weif3383-cloud/sweeping-robot/代辦.md

# 代辦

## 🔜 下一步：MPU6050 上車測試（robot_wifi）
- [x] MPU6050 平貼在下層、靠近兩輪中間、晶片朝上、貼牢（SDA 21、SCL 22、3.3V、GND）
- [x] 在 `robot_wifi/` 把 `secrets_example.h` 複製成 `secrets.h`，填家裡 WiFi（2.4 GHz）
- [x] 燒錄 `robot_wifi.ino`，開機時車子靜止 1 秒（量零點）
- [x] 電腦開 http://robot.local（或網頁上的 IP），確認網頁正常
- [x] 用手順時針轉車子，陀螺儀方向要變大（變小就按「反轉方向」）
- [x] 跑一次原地轉 90°，看回報「陀螺儀 vs 編碼器推算」差多少
- [x] 跟 Claude 說，讓 Claude 讀 http://robot.local/data 分析數據

## 之後：陀螺儀控制
- [x] 階段 ③：原地轉彎改用陀螺儀角度停 — 實測 90° 準到 ±0.5°
- [x] 階段 ③-2：提前量跟著轉速 — 實測 45°/90°/180° 都在 ±1°
- [x] 階段 ④：直走鎖定方向 — 實測偏差從 −7° 降到 ±0.9°
- [x] 陀螺儀比例校正：轉 360° 陀螺儀說 359°、目視也差約 1° → 比例正確
- [x] 燒錄 v4、自動學直走微調（鎖方向開時偏 ±1.2° 內）
- [x] 燒錄 v5（左右輪大小比例）→ 鎖方向關掉時偏差從 −4°～+5° 降到大多 ±1° 內
- [ ] 無線燒錄：Windows WiFi 設成私人網路、防火牆允許 espota / Arduino IDE
- [x] 測試偏移是車子還是地板 → 主要是車子（一直往車子左邊偏），地板讓偏差忽大忽小
- [x] 輪距校正：陀螺儀實測 6 次轉彎 → 199 mm
- [x] 輪徑校正：30 cm 尺量 3 趟 → 66.9 mm（距離誤差從約 3% 降到 0）
- [x] 燒錄 v6（照地圖修正路線）→ 正方形測試回到起點只差 1.2 cm
- [ ] 查為什麼 Claude 連不上機器人網頁（看序列埠的 IP / WiFi 訊息）

## 紅外線感測器 ×2（已決定：第一層側面，貼牆碰觸偵測；沒有防跌落）
- [x] 模組是 4 腳（VCC / GND / A0 / D0），只接 D0，A0 不接
- [x] 腳位寫進 `docs/PINOUT_v2.md` 第 6.5 節：左 D0 → GPIO 16、右 D0 → GPIO 17，VCC 接 3.3V
- [ ] 接線並燒錄 `迭代四_感測器/ir_test/ir_test.ino`，確認靠近 / 遠離的讀值與極性（先接一顆也可以）
- [ ] 調模組上的電位器，確認貼牆多近會偵測到
- [ ] 注意：沒有防跌落 → 測試只能在平地、遠離桌邊和樓梯
- [ ] （之後可選）前保險桿微動開關 GPIO 18 / 19（已預留）

## 掃地演算法（規劃見 `docs/演算法規劃.md`）
- [x] `迭代五_演算法/sweep_sim.html` 網頁模擬器（階段 1：空場地）— 2×2 m 模擬覆蓋率平均 93%、最差 90.7%
- [ ] 使用者試玩模擬器，確認流程是不是他要的
- [ ] 紅外線、超音波實測（ir_test），確認實際偵測距離，回頭調模擬器參數
- [x] robot_wifi v7：`O` 設定座標、/status 回報超音波與紅外線、`P x,y,1` 超音波 8 cm 停、超音波 5 次平均、CORS（模擬測試：設 8 cm 停在 7.2～7.7 cm）
- [ ] 燒錄 v7（先關 Arduino IDE 再讓 Claude 寫入），網頁「感測器」卡片確認超音波距離和紅外線 ●○ 正確
- [ ] 模擬器加「連接實車」：把 cleanRoom 的 bot 介面接到 /cmd、/status（座標系換算：韌體 y 朝前、順時針為正）
- [ ] 實車階段 1：網頁規劃 → 控制實車；驗收：覆蓋率 > 90%、終點離模擬值 5 cm 內
- [ ] 階段 2：加障礙物（超音波偵測、牆驗證、繞過 / 補掃），保留手動輸入場地大小

## 硬體
- [ ] 上層底盤列印與組裝
- [ ] 選吸塵風扇、側刷、濾網；設計集塵盒、吸塵嘴、風扇座、上蓋
- [ ] HC-SR04（分壓）、N20 側刷 + MOSFET + 1N5819、電源（BMS / Type-C 充電 / MP1584 5.0 V）上車測試

## 完成
- [x] 第一版小車、遙控
- [x] v2 下層底盤列印與組裝
- [x] 編碼器讀取、走指定圈數、提前量自動學習、左右同步、柔和停車、20/40 格
- [x] 無線網頁控制、路徑地圖（encoder_wifi）
- [x] GitHub 同步（weif3383-cloud/sweeping-robot）
