weif3383-cloud/sweeping-robot/迭代三_陀螺儀/說明.md

# 迭代三：陀螺儀（目前最新）

加入 MPU6050 陀螺儀，車頭方向不再只靠編碼器推算。

| 順序 | 程式 | 做什麼 |
|---|---|---|
| 1 | `robot_wifi/` | **目前主程式**：encoder_wifi ＋ 陀螺儀（自動零點、正負號自動判斷、地圖方向）＋ 家裡 WiFi ＋ `/data` 數據 |

家裡 WiFi：把 `robot_wifi/secrets_example.h` 複製成 `secrets.h` 填入（不會上傳 GitHub）。

## v7（2026-11-15）：給掃地演算法用
- 超音波 HC-SR04（Trig 4、Echo 經分壓 → 39）：每 60 ms 量一次，網頁「感測器」卡片顯示
- 紅外線 ×2（D0 → 16 / 17）：網頁顯示 ●（偵測到）○（沒有）；如果剛好相反，打 `I0`
- 新指令：
  - `P60,0,1`：走到 (60, 0)，途中前方超音波 ≤ 8 cm 就停（`V8` 改距離）
  - `O30,12,90`：直接設定目前座標與方向（空著的欄位不改，例如 `O,,90`）
  - `U`：印出超音波與紅外線讀值
- `/status` 多了 `son`（超音波平均 cm，-1 = 量不到）、`sn1`、`irl`、`irr`、`blk`（上一個 P 被擋住）
- 電腦上直接開的網頁（例如 `迭代五_演算法/sweep_sim.html`）也可以呼叫 `/cmd`、`/status`（加了 CORS）
- 超音波沒接的話讀值會亂跳或量不到，其他功能不受影響
