weif3383-cloud/sweeping-robot/迭代五_演算法/說明.md

# 迭代五：掃地演算法

| 檔案 | 用途 | 狀態 |
|---|---|---|
| `sweep_sim.html` | 網頁模擬器（階段 1：空場地）。用瀏覽器直接開，不用安裝 | 2026-11-15 完成，模擬驗證過 |

規劃的決定與限制見 `docs/演算法規劃.md`。

## 怎麼用
1. 在檔案上按兩下，用瀏覽器（Chrome / Edge）開啟 `sweep_sim.html`。
2. 按「開始清掃」。左邊是真實情況（白色＝真的掃過），右邊是機器人自己以為的地圖。
3. 可以改：場地寬 / 長（80～300 cm）、亂數（換一個數字＝換一個起點和一組誤差）、誤差大小、模擬速度。
4. 「碰牆校正座標」「沿牆繞一圈」可以關掉，比較有沒有差。

## 演算法流程（`cleanRoom`）
1. **找角落**：往前走到牆（超音波 8 cm 停），左轉走到第二面牆。角落＝原點，順便量對面兩面牆的位置。
2. **弓字形**：行距 20 cm，每行走到前面的牆為止。每行走完用超音波修正 x、y，並從「這一行左右偏了多少」反推車頭歪幾度一起修正。
3. **沿牆繞一圈**：車身離牆 2 cm，牆在右手邊。每 40 cm 看一次右邊紅外線修正離牆距離（亮＝太近或剛好，沒亮＝太遠）。
4. **走回起點**。

## 模擬結果（2×2 m，各 12 組亂數）
| 誤差 | 校正 | 覆蓋率 平均 / 最差 | 最後定位誤差 平均 | 撞牆 平均 |
|---|---|---|---|---|
| 1× | 開 | 93.0% / 90.7% | 2.6 cm | 1.4 次 |
| 1× | 關 | 91.0% / 84.6% | 3.3 cm | 3.5 次 |
| 2× | 開 | 92.1% / 87.6% | 4.7 cm | 3.8 次 |
| 2× | 關 | 88.5% / 77.4% | 6.4 cm | 4.3 次 |

- 「撞牆」是貼牆走（離牆 2 cm）時車身碰到牆，不是高速撞上去。
- 「誤差 1×」是猜的：里程計距離 ±1%、陀螺儀漂移 ±0.01 °/s、起點車頭歪 ±1.5°、超音波 ±0.3 cm 起跳。實車的誤差要上車後才知道。

## 已知限制
- 只適用**長方形、沒有障礙物**的場地（障礙物是階段 2）。
- 起點要**大致正對一面牆**（歪超過約 25° 超音波量不到）。
- 場地邊長超過約 3 m，超音波量不到對面的牆。
- 圓形車身掃不到四個角落，牆邊約 3 cm 也掃不到，所以覆蓋率上限大約 95%。

## 程式結構
- 第一部分「規劃程式」只透過 `bot` 介面（`setPose` / `turnTo` / `goTo` / `sense`）控制機器人，模擬器和實車共用。
- 上實車前，`robot_wifi` 要新增：
  - 設定座標的指令（對應 `setPose`）
  - `/status` 回報超音波距離和左右紅外線
  - `P x,y` 加「超音波 ≤ 8 cm 就停」的選項，並回報是不是被擋住
  - 超音波連量 5 次取平均
