weif3383-cloud/sweeping-robot/迭代一_小車馬達/說明.md

# 迭代一：小車馬達

第一版小車，讓馬達動起來。

| 順序 | 程式 | 做什麼 |
|---|---|---|
| 1 | `car_test/` | 序列埠打指令測馬達（w/s/a/d、單輪、PWM 調整） |
| 2 | `car_test02/` | car_test 的修改版 |

（手機遙控 `remote_car` 放在桌面另一個資料夾）
