weif3383-cloud/sweeping-robot/迭代二_編碼器/說明.md

# 迭代二：編碼器

加入 HC-020K 編碼器，知道輪子轉了幾格，再做成無線控制。

| 順序 | 程式 | 做什麼 |
|---|---|---|
| 1 | `encoder_test/` | 編碼器測試：計時器抗抖動、馬達一起測 |
| 2 | `encoder_read/` | 編碼器讀取 → 走指定圈數 → 提前煞車、自動學習（序列埠版） |
| 3 | `encoder_wifi/` | 無線網頁版：左右同步、柔和停車、20/40 格、路徑地圖（沒有 MPU 的穩定版） |
