weif3383-cloud/sweeping-robot/迭代四_感測器/說明.md

# 迭代四：感測器（紅外線、超音波、保險桿）

| 程式 | 用途 | 狀態 |
|---|---|---|
| `ir_test/ir_test.ino` | 紅外線 ×2 讀值測試（GPIO 16 / 17） | 2026-11-15 寫好，等使用者接線測試 |

- 腳位見 `docs/PINOUT_v2.md` 第 6.5 節。
- ■ 表示 OUT = 0（多數模組代表偵測到東西），□ 表示 OUT = 1。
