weif3383-cloud/sweeping-robot/cad/prev_lower_iso.png

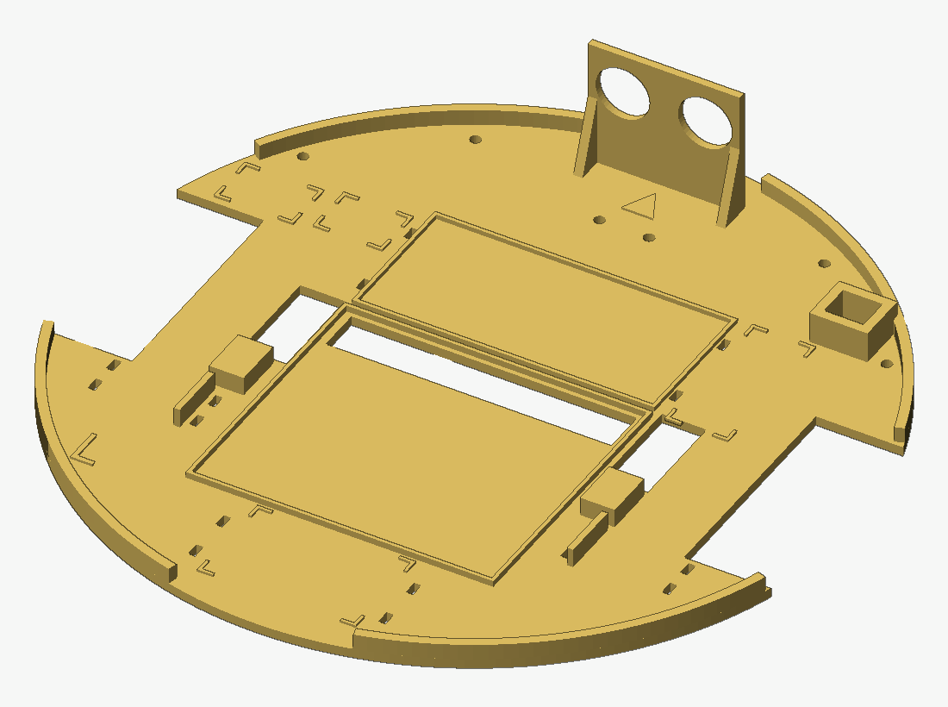
cad/prev_lower_iso.png
