weif3383-cloud/sweeping-robot/cad/prev_upper_iso.png

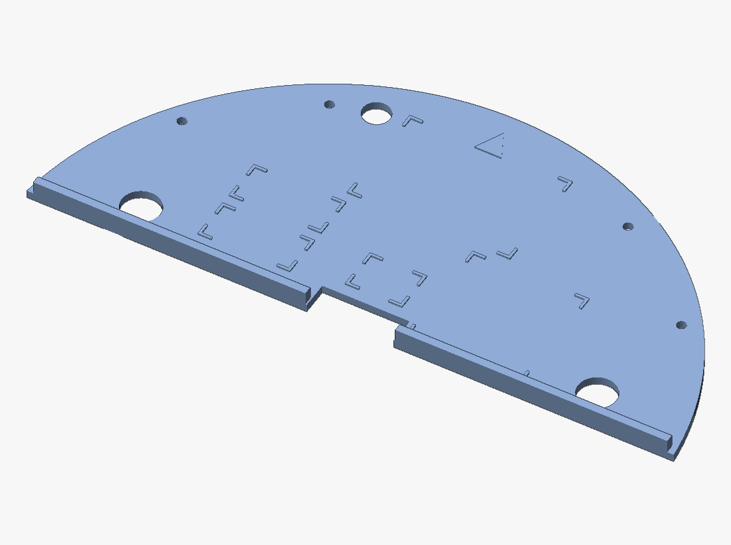
cad/prev_upper_iso.png
