weif3383-cloud/sweeping-robot/layout_v2_draft.png

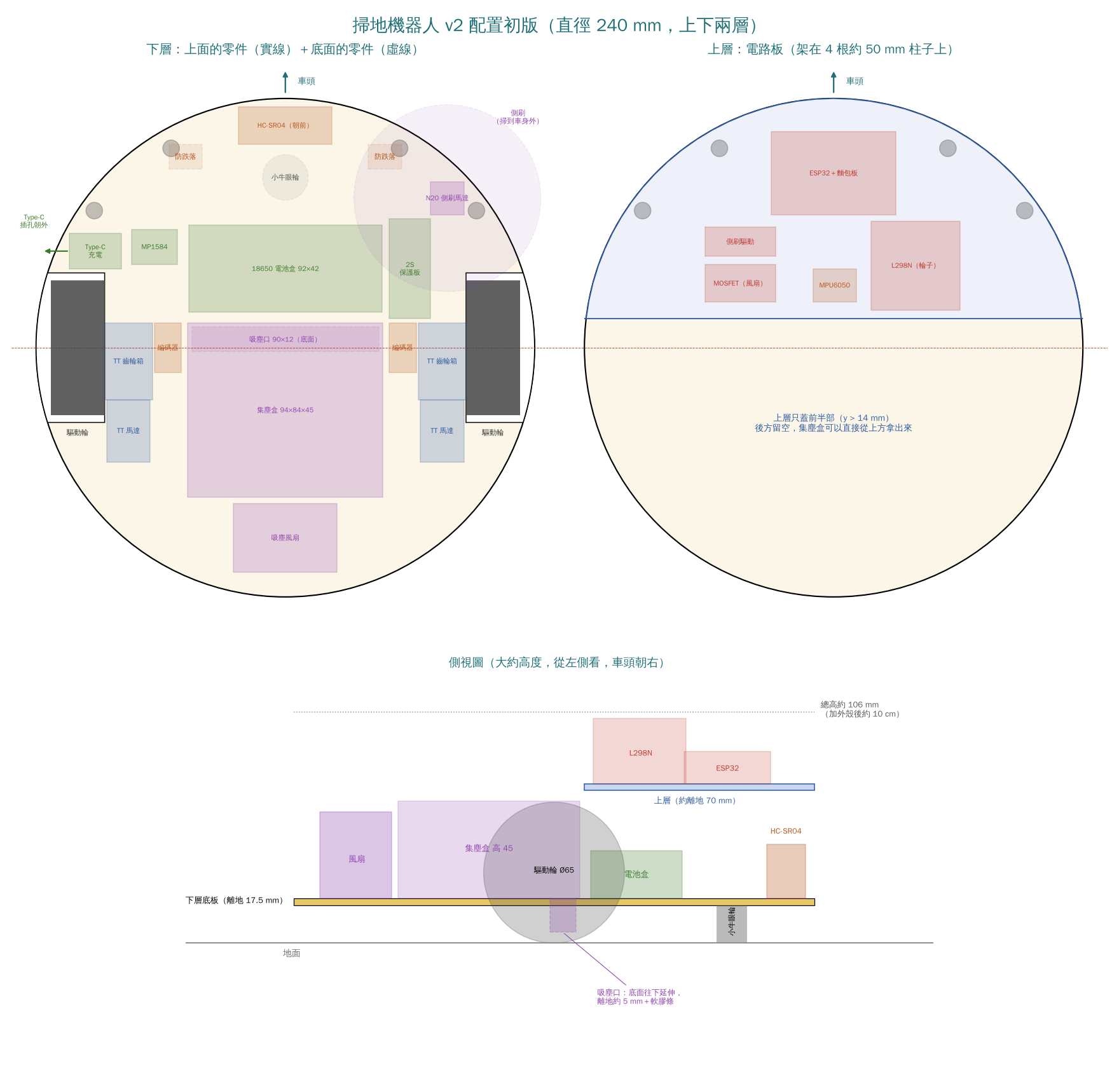
layout_v2_draft.png
