weif3383-cloud/sweeping-robot/cad/robot_v2_lower_deck.stl

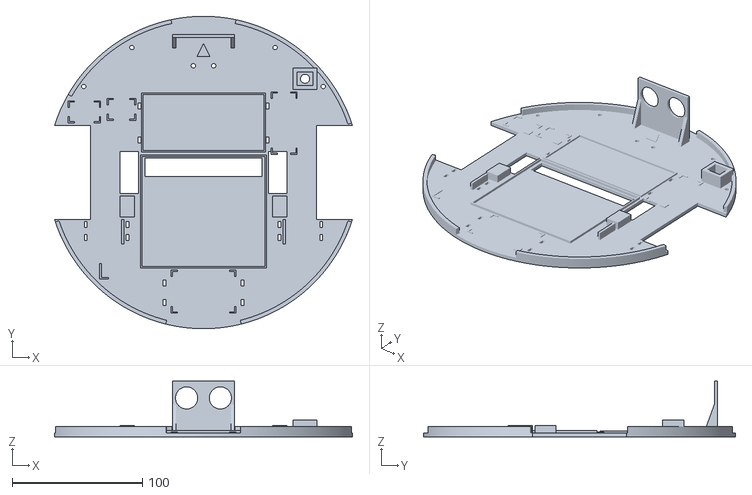
[picture p6: CAD file, 2026-11-07]
cad/robot_v2_lower_deck.stl
228.9 x 240.0 x 43.0
