weif3383-cloud/sweeping-robot/cad/robot_v2_upper_deck.stl

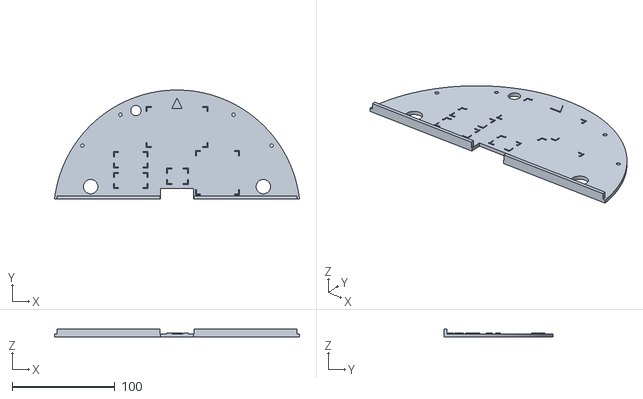
[picture p7: CAD file, 2026-11-07]
cad/robot_v2_upper_deck.stl
238.4 x 106.0 x 8.00
