weif3383-cloud/sweeping-robot/cad/assembly_lower_v2.png

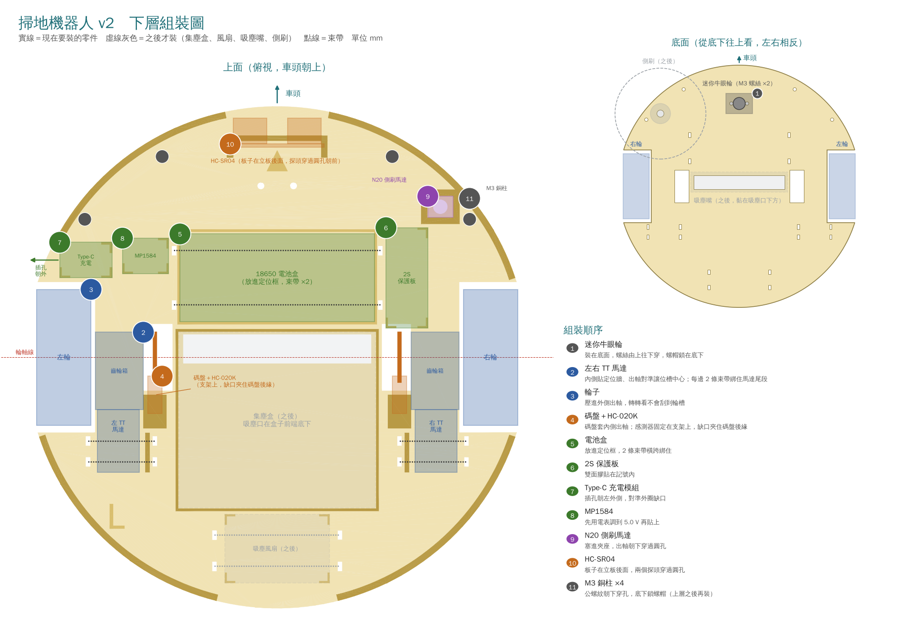
cad/assembly_lower_v2.png
