weif3383-cloud/sweeping-robot/TODO.md

# 待辦清單

## 🔜 下一步：MPU6050 上車測試（robot_wifi）
- [ ] MPU6050 平貼在下層、靠近兩輪中間、晶片朝上、貼牢（SDA 21、SCL 22、3.3V、GND）
- [ ] 在 `robot_wifi/` 把 `secrets_example.h` 複製成 `secrets.h`，填家裡 WiFi（2.4 GHz）
- [ ] 燒錄 `robot_wifi.ino`，開機時車子靜止 1 秒（量零點）
- [ ] 電腦開 http://robot.local（或網頁上的 IP），確認網頁正常
- [ ] 用手順時針轉車子，陀螺儀方向要變大（變小就按「反轉方向」）
- [ ] 跑一次原地轉 90°，看回報「陀螺儀 vs 編碼器推算」差多少
- [ ] 跟 Claude 說，讓 Claude 讀 http://robot.local/data 分析數據

## 之後：陀螺儀控制
- [ ] 階段 ③：原地轉彎改用陀螺儀角度停（快到時減速）
- [ ] 階段 ④：直走鎖定方向（陀螺儀 + 編碼器同步一起用）
- [ ] 陀螺儀比例校正（原地轉 5 圈，看實際轉幾圈）
- [ ] 正方形測試校正輪徑 `D` 與輪距 `W`

## 硬體
- [ ] 上層底盤列印與組裝
- [ ] 紅外線感測器 ×2 用途與安裝（討論中）
- [ ] 選吸塵風扇、側刷、濾網；設計集塵盒、吸塵嘴、風扇座、上蓋
- [ ] HC-SR04（分壓）、N20 側刷 + MOSFET + 1N5819、電源（BMS / Type-C 充電 / MP1584 5.0 V）上車測試

## 完成
- [x] 第一版小車、遙控
- [x] v2 下層底盤列印與組裝
- [x] 編碼器讀取、走指定圈數、提前量自動學習、左右同步、柔和停車、20/40 格
- [x] 無線網頁控制、路徑地圖（encoder_wifi）
- [x] GitHub 同步（weif3383-cloud/sweeping-robot）
