weif3383-cloud/sweeping-robot/(commit log)

2026-11-07 初始上傳：目前所有程式、設計檔與腳位表
    Claude-Session: https://claude.ai/code/session_016VkQpYHki4jqupFq9L7GeY
    [robot_v2_lower_deck.stl, robot_v2_upper_deck.stl]
2026-11-07 加入專案工作筆記 CLAUDE.md
    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
2026-11-07 新增 robot_wifi：MPU6050 陀螺儀、家裡 WiFi、/data 數據
    - 陀螺儀 Z 軸：開機量零點、停車時自動更新零點、正負號自動判斷
    - 地圖方向改用陀螺儀，網頁同時顯示編碼器推算方向比較
    - secrets.h 連家裡 WiFi（保留 RobotCar 熱點），robot.local
    - /data 提供參數、狀態、最近 30 趟紀錄
    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
2026-11-07 新增待辦清單 TODO.md
    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
2026-11-07 待辦清單改名為 代辦.md，加入紅外線感測器 TCRT5000 項目
    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
2026-11-07 程式依迭代分類：迭代一小車馬達、迭代二編碼器、迭代三陀螺儀
    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
2026-11-07 robot_wifi：轉彎改用陀螺儀決定停、輪距校正為 199 mm
    - 陀螺儀轉彎：最後 35° 減速，提前量左右各自學習並存在 Preferences
    - 正負號確認狀態、輪徑、輪距也存起來，重開機不用重來
    - 方向相反時立刻翻正負號，避免一直轉
    - 實測 6 次轉彎（陀螺儀 vs 編碼器）算出有效輪距 199 mm
    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
2026-11-07 robot_wifi v3：轉彎提前量跟著轉速、直走用陀螺儀鎖方向
    - 實測：固定提前度數讓 90° 準到 ±0.5°，但 45° 少轉、180° 多轉
    → 改學時間常數 K（提前度數 = K × 放開時轉速），左右各自學
    - 直走鎖方向：陀螺儀 PID + 編碼器同步只留 40% 比例項，兩輪平均走到才一起停
    - 新指令 J（鎖方向開關）、K（鎖方向參數），網頁加開關
    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
2026-11-07 robot_wifi：加入無線燒錄（OTA）
    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
2026-11-07 robot_wifi：寫入實車校準值（轉彎 K、直走鎖方向 PID），鎖方向參數也存起來
    實測（2026-11-07）：
    - 轉彎 26 次學出 K 右 0.094 / 左 0.079 秒，45°/90°/180° 誤差都在 ±1° 內
    - 直走 2 圈：鎖方向關 −4.7～−7.1°；KH14/KHI25/KHD0.7 → ±0.9° 內
    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
2026-11-07 robot_wifi v4：直走微調自動學習、直走一律平均走到一起停
    - 實測車子本身往左偏（左輪吃虧），學一個前進 / 後退各自的左右 PWM 微調並存起來
    - 鎖方向關掉時也改成兩輪平均走到一起停（之前各自停會在最後扭一下）
    - 直走提前量改用平均誤差學，左右保持一樣
    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
2026-11-07 robot_wifi v5：學左右輪大小比例
    v4 實測：PWM 微調在鎖方向關掉時沒用，因為編碼器同步堅持左右格數一樣；
    實際走直需要左輪多轉約 2.3%（10 趟平均 dl/dr = 1.023）。
    改學 wheelRatio，用在編碼器同步、直走距離、地圖。
    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
2026-11-07 v5 實車結果：輪子比例 1.034，鎖方向關掉也幾乎走直
    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
2026-11-07 陀螺儀比例確認正確（360° 目視與陀螺儀一致）
    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
2026-11-07 輪徑校正為 66.9 mm（30 cm 尺實測 3 趟）
    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
2026-11-07 更新工作筆記：運動校準完成
    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
2026-11-07 robot_wifi v6：照地圖修正路線（走到某點、轉到絕對方向）
    - 正方形測試改成依序走到 4 個角（每段都用目前位置重新算方向和距離），誤差不再累積
    - 新指令 P x,y（走到地圖某點）、A 角度（轉到地圖絕對方向）
    - 直走鎖住「指向目標點」的方向
    - 每圈格數存進 ESP32，預設 40 格
    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
    [robot_wifi.ino]
2026-11-07 v6 實測：正方形回到起點只差 1.2 cm
    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
2026-11-14 PINOUT：新增紅外線 GPIO16/17、保險桿預留 GPIO18/19、側刷模組 ZX-517
    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
2026-11-14 迭代四：紅外線測試程式 ir_test
    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
2026-11-14 PINOUT：紅外線改為 4 腳模組，只接 D0（GPIO 16/17），A0 不接
    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
2026-11-14 代辦與演算法規劃：紅外線決定、掃地演算法 grill-me 結論
    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
2026-11-14 代辦：紅外線決定、掃地演算法規劃（尚未開始實作）
    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
2026-11-14 迭代五：掃地演算法網頁模擬器（階段 1 空場地）
    找角落、弓字形、沿牆繞一圈、走回起點；超音波校正座標與車頭方向、紅外線修正貼牆距離。
    模擬 2x2 m：覆蓋率平均 93%。
    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
2026-11-14 robot_wifi v7：超音波、紅外線、P 前方有牆就停、O 設定座標、CORS
    給掃地演算法用：/status 回報超音波平均與紅外線，P x,y,1 前方 8 cm 停並回報被擋住。
    模擬測試：設 8 cm 時停在 7.2-7.7 cm。
    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
